AbheerParashar/Airaavat-V2/media/README.md

# 📸 Media

| What | Link |
| --- | --- |
| V2 raw ground trials, 7 Oct 2026 (Instagram reel) | [Watch](https://www.instagram.com/reel/DebHqPeTG6g/) |
| Project status update (LinkedIn post) | [Read](https://lnkd.in/p/dG7HBqwb) |
| V2 first wireless ground trial, 7 Oct 2026 (video) | [Watch](https://drive.google.com/file/d/1QRCBFcqSwdifOWkJ_7g2vigKBfFnSC9H/view) |
| V2 chassis and drivetrain (photos) | [View](https://drive.google.com/file/d/1C93mtSYO8mE3alvMaw7EJWNpeyAZyHTz/view) |
| V2 electronics, TX and RX (video) | [Watch](https://drive.google.com/file/d/1DSDDPnvuS9_KyFwt1rEXlqGeaNej8uOG/view) |
| Airaavat-V1 (photos) | [View](https://drive.google.com/file/d/1gV1h5qYiknShmPxmCoaLPKeFRJbFTL5w/view) |
| Handwritten logbook scans | [View](https://drive.google.com/file/d/10TbniN784dZL7cTZX2MVMiaOBvDbJyK9/view) |
