AbheerParashar/Airaavat-V2/LEDGER.md

# 📒 Phase 1 Ledger

Every contribution and every purchase for Phase 1 is recorded here. Bills are added to a `ledger/bills/` folder in this repository as they come in.

📄 Campaign page (budget and UPI): https://claude.ai/artifact/WNasbuVM9mPWcAJvxugBxs

## Progress

| Milestone | Target | Raised | Status |
| --- | --- | --- | --- |
| 1 · Build the packs the right way | ₹15,000 | ₹0 | 🟡 Funding now |
| 2 · Charge, protect and measure | ₹8,200 | ₹0 | ⏳ Next |
| 3 · Keep the build moving | ₹9,200 | ₹0 | ⏳ After that |
| **Phase 1 total** | **₹32,400** | **₹0** | |

## Contributions

Names are listed only with the supporter's permission. Otherwise the entry reads "Anonymous".

| Date | Supporter | Amount | Milestone |
| --- | --- | --- | --- |
| | | | |

## Purchases

At the supplier's request, the per-cell price is not published; the cells and nickel strip appear as one line.

| Date | Item (model) | Seller | Amount | Bill | Milestone |
| --- | --- | --- | --- | --- | --- |
| | | | | | |

## Balance

| | Amount |
| --- | --- |
| Total received | ₹0 |
| Total spent | ₹0 |
| **Balance** (carried to the next milestone) | **₹0** |
