AbheerParashar/Airaavat-V2/logbook/README.md

# 📒 Engineering Logbook

The **handwritten logbook is the primary record.**

| Record | Contents |
| --- | --- |
| [V1 handwritten logbook (PDF)](Project_Airaavat_V1_Documentation.pdf) | Airaavat-V1, March–August 2026: battery-pack milestones, TX/RX pin maps, drivetrain sketches, sprocket specifications |
| [Logbook scans (Google Drive)](https://drive.google.com/file/d/10TbniN784dZL7cTZX2MVMiaOBvDbJyK9/view) | Scanned pages from the paper logbook |
