AbheerParashar/Airaavat-V2/(commit log)

2026-10-12 Change ground-trial video link in README
    Updated ground-trial video link to Google Drive.
2026-10-12 Revise ground-trial video link and social media info
    Updated the ground-trial video link and added an Instagram reference.
2026-10-12 Revise ground-trial video link in README
    Updated ground-trial video link and added a note for future updates.
2026-10-12 Revise drivetrain speed data and measurement method
    Updated V2 measured run entry with pending speed information and clarified speed measurement instructions.
2026-10-18 Update campaign page link in Phase 1 Ledger
